PietPtr/trumpet_synth/web/frontend/README.md

# Install / Serve

```
cargo install dioxus-cli --locked --version "0.6.3"
dx serve --platform web
```

when making changes to the WASM part  make sure to first run build.sh in wasm-audio, then cargo build here.
