PietPtr/trumpet_synth/pcbs/trumpet_synth_mainboard/trumpet_synth_mainboard.kicad_pcb

## KiCad design pcbs/trumpet_synth_mainboard/trumpet_synth_mainboard.kicad_pcb (2025-10-15)

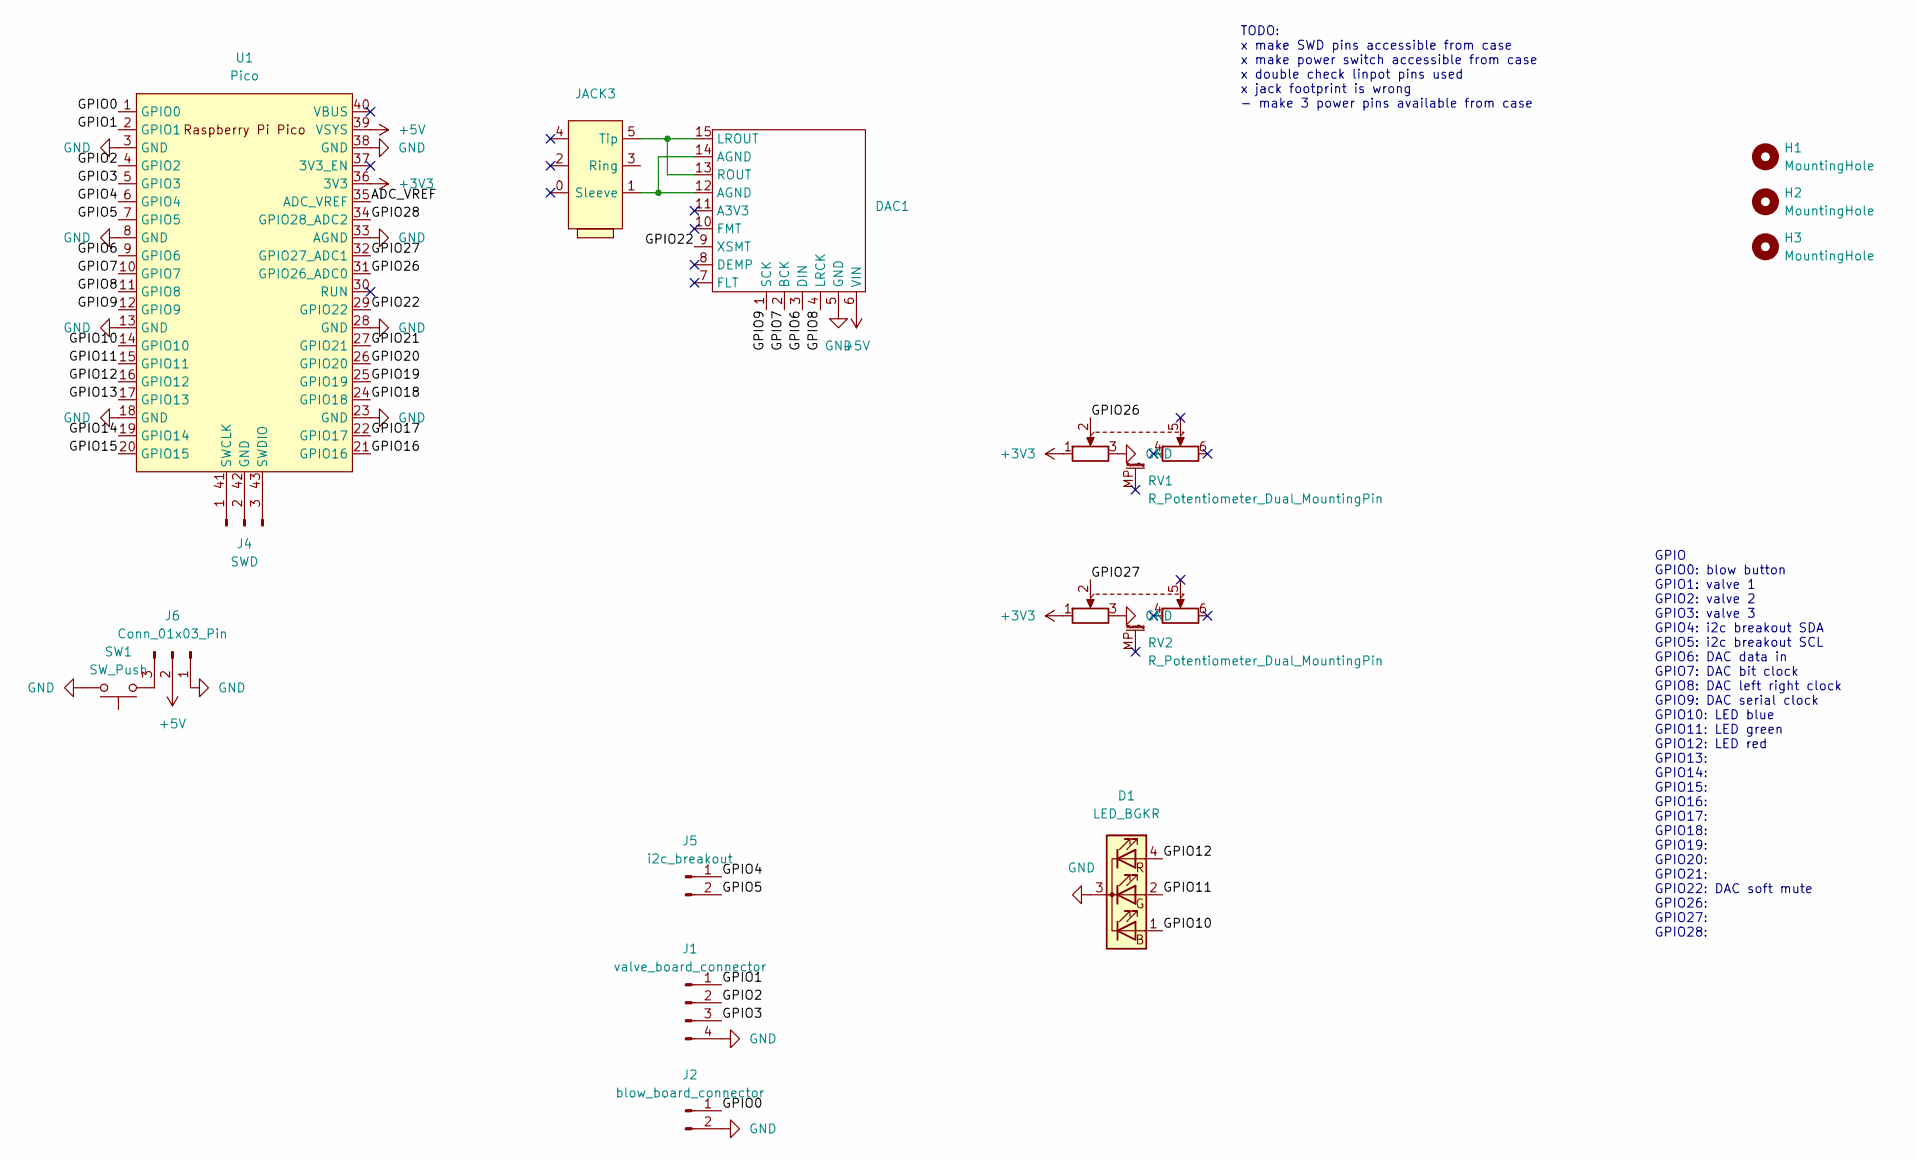
[picture p1: schematic trumpet_synth_mainboard.kicad_sch]

Parts:
D1: LED_BGKR; LED_D5.0mm-4_RGB
DAC1: PCM5102_BREAKOUT
H1, H2, H3: MountingHole; MountingHole_3.2mm_M3
J1: valve_board_connector; PinHeader_1x04_P2.54mm_Vertical
J2: blow_board_connector; PinHeader_1x02_P2.54mm_Vertical
J4: SWD; PinHeader_1x03_P2.54mm_Vertical
J5: i2c_breakout; PinHeader_1x02_P2.54mm_Vertical
J6: Conn_01x03_Pin; PinHeader_1x03_P2.54mm_Vertical
JACK3: SlimJack6.3
RV1, RV2: R_Potentiometer_Dual_MountingPin; linpot_75mm
SW1: SW_Push; PinHeader_1x03_P2.54mm_Vertical
U1: Pico; RPi_Pico_SMD

Connections:
+3V3: RV1.1, RV2.1, U1.36 (3V3)
+5V: DAC1.6 (VIN), J6.2, U1.39 (VSYS)
/ADC_VREF: U1.35 (ADC_VREF)
/GPIO0: J2.1, U1.1 (GPIO0)
/GPIO1: J1.1, U1.2 (GPIO1)
/GPIO2: J1.2, U1.4 (GPIO2)
/GPIO3: J1.3, U1.5 (GPIO3)
/GPIO4: J5.1, U1.6 (GPIO4)
/GPIO5: J5.2, U1.7 (GPIO5)
/GPIO6: DAC1.3 (DIN), U1.9 (GPIO6)
/GPIO7: DAC1.2 (BCK), U1.10 (GPIO7)
/GPIO8: DAC1.4 (LRCK), U1.11 (GPIO8)
/GPIO9: DAC1.1 (SCK), U1.12 (GPIO9)
/GPIO10: D1.1 (BA), U1.14 (GPIO10)
/GPIO11: D1.2 (GA), U1.15 (GPIO11)
/GPIO12: D1.4 (RA), U1.16 (GPIO12)
/GPIO13: U1.17 (GPIO13)
/GPIO14: U1.19 (GPIO14)
/GPIO15: U1.20 (GPIO15)
/GPIO16: U1.21 (GPIO16)
/GPIO17: U1.22 (GPIO17)
/GPIO18: U1.24 (GPIO18)
/GPIO19: U1.25 (GPIO19)
/GPIO20: U1.26 (GPIO20)
/GPIO21: U1.27 (GPIO21)
/GPIO22: DAC1.9 (XSMT), U1.29 (GPIO22)
/GPIO26: RV1.2, U1.31 (GPIO26_ADC0)
/GPIO27: RV2.2, U1.32 (GPIO27_ADC1)
/GPIO28: U1.34 (GPIO28_ADC2)
GND: D1.3 (K), DAC1.5 (GND), J1.4, J2.2, J6.1, RV1.3, RV2.3, SW1.2, U1.3 (GND), U1.8 (GND), U1.13 (GND), U1.18 (GND), U1.23 (GND), U1.28 (GND), U1.33 (AGND), U1.38 (GND)
unnamed: DAC1.13 (ROUT), DAC1.15 (LROUT), JACK3.5 (Tip)
unnamed: J4.1, U1.41 (SWCLK)
unnamed: J4.2, U1.42 (GND)
unnamed: J4.3, U1.43 (SWDIO)
unnamed: J6.3, SW1.1
unnamed: DAC1.12 (AGND), DAC1.14 (AGND), JACK3.1 (Sleeve)

Notes on the sheet:
TODO: x make SWD pins accessible from case x make power switch accessible from case x double check linpot pins used x jack footprint is wrong - make 3 power pins available from case
GPIO GPIO0: blow button GPIO1: valve 1 GPIO2: valve 2 GPIO3: valve 3 GPIO4: i2c breakout SDA GPIO5: i2c breakout SCL GPIO6: DAC data in GPIO7: DAC bit clock GPIO8: DAC left right clock GPIO9: DAC serial clock GPIO10: LED blue GPIO11: LED green GPIO12: LED red GPIO13: GPIO14: GPIO15: GPIO16: GPIO17: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

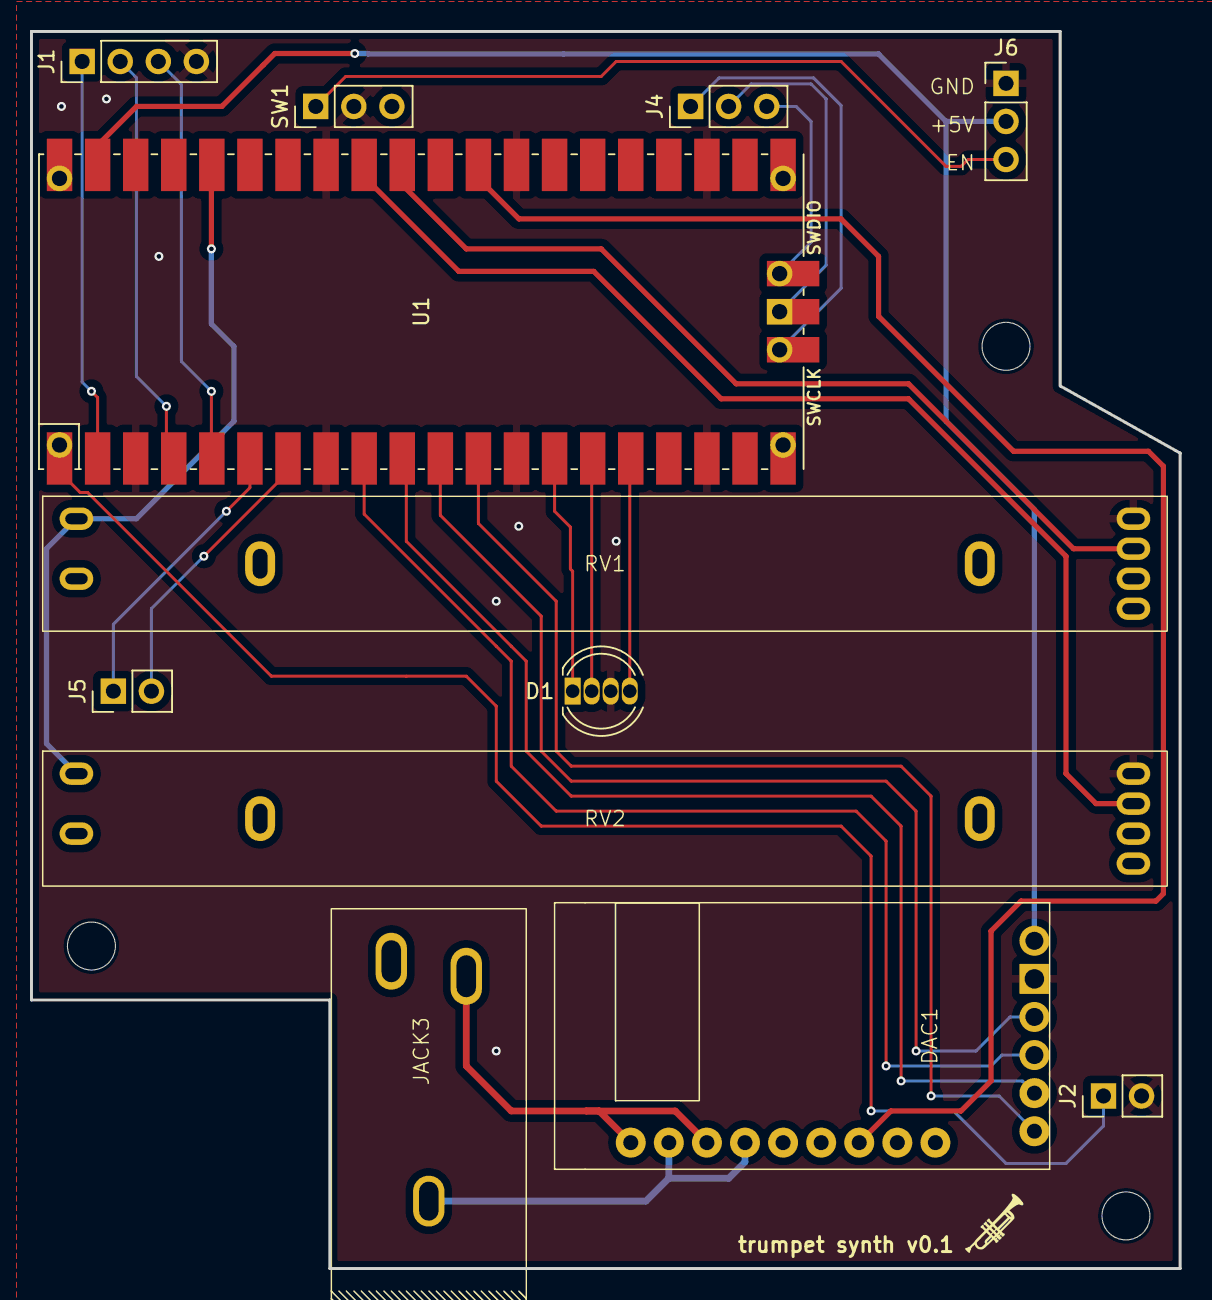
[picture p2: board trumpet_synth_mainboard.kicad_pcb from above]

Board: 2 copper layers, 76.6 x 82.5 mm, 15 parts (0 on the bottom side), 25 nets.
