PietPtr/trumpet_synth/pcbs/valves_board/valves_board.kicad_pcb

## KiCad design pcbs/valves_board/valves_board.kicad_pcb (2025-10-13)

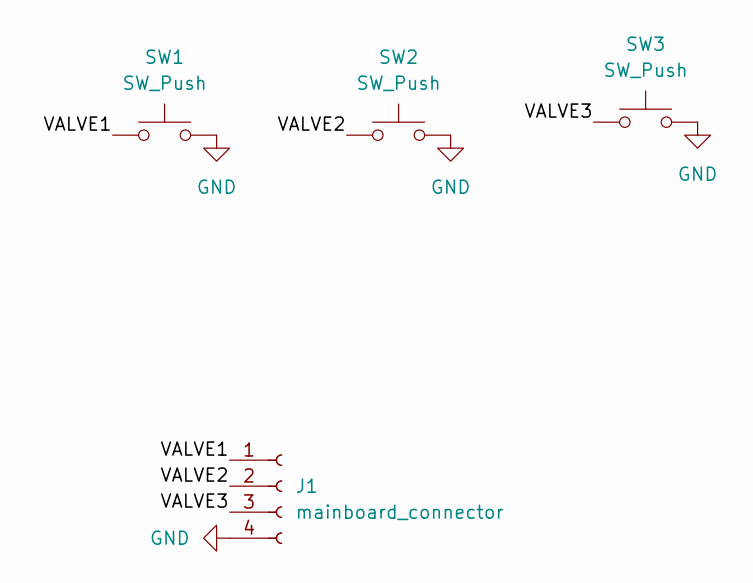
[picture p3: schematic valves_board.kicad_sch]

Parts:
J1: mainboard_connector; PinSocket_1x04_P2.54mm_Vertical
SW1, SW2, SW3: SW_Push; SW_Cherry_MX_1.00u_PCB

Connections:
/VALVE1: J1.1, SW1.1
/VALVE2: J1.2, SW2.1
/VALVE3: J1.3, SW3.1
GND: J1.4, SW1.2, SW2.2, SW3.2

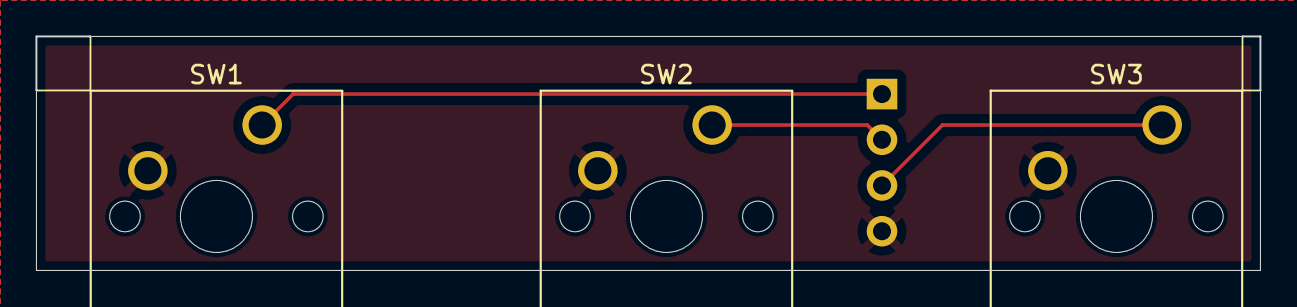
[picture p4: board valves_board.kicad_pcb from above]

Board: 2 copper layers, 68.0 x 13.0 mm, 4 parts (1 on the bottom side), 4 nets.
