PietPtr/trumpet_synth/(commit log)

2025-05-27 Create button logic
2025-10-12 Working rp2040 frontend, design pcbs
    [blow_button_board.kicad_pcb, blow_button_board.kicad_sch, trumpet_synth_mainboard.kicad_pcb, trumpet_synth_mainboard.kicad_sch, valves_board.kicad_pcb, valves_board.kicad_sch]
2025-10-13 Update PCBs
    [blow_button_board.kicad_pcb, trumpet_synth_mainboard.kicad_pcb, trumpet_synth_mainboard.kicad_sch, valves_board.kicad_pcb]
2025-10-15 Order all PCBs v0.1
    [trumpet_synth_mainboard.kicad_pcb, trumpet_synth_mainboard.kicad_sch]
2025-10-31 Tests on PCB
    [trumpet_synth_mainboard.kicad_sch]
2025-11-04 Add test case to emit to wav
